mcy7880/R820T2-and-STM32F407-SDR-receiver/Doc/r820t_module pinout.pdf

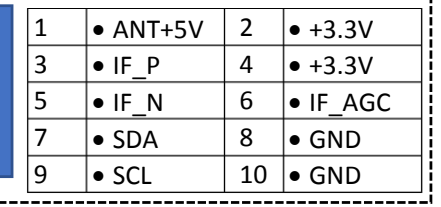
[picture p1: figure]
• ANT+5V; • IF_AGC; • SDA; • GND; • SCL

RF_IN

RF_LOOP

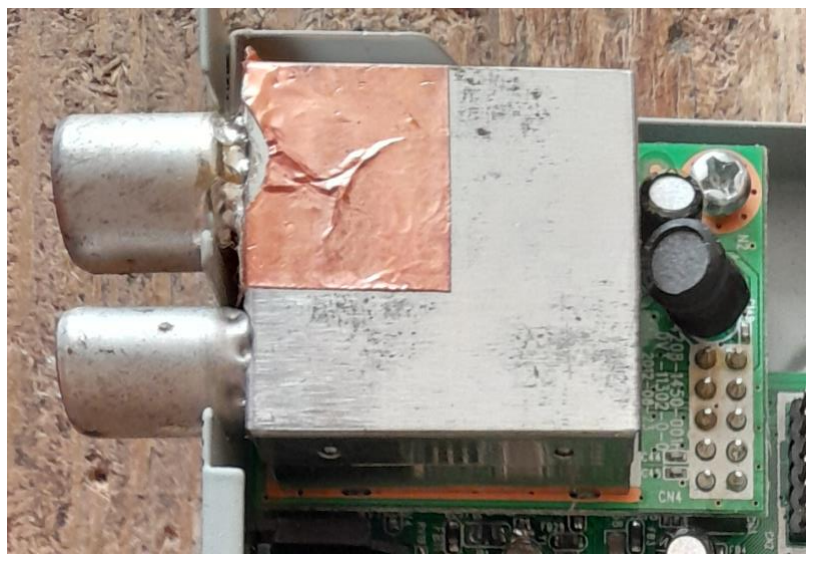
[picture p2: figure]
