mcy7880/R820T2-and-STM32F407-SDR-receiver/Doc/up_converter_schematic/up_converter.pdf

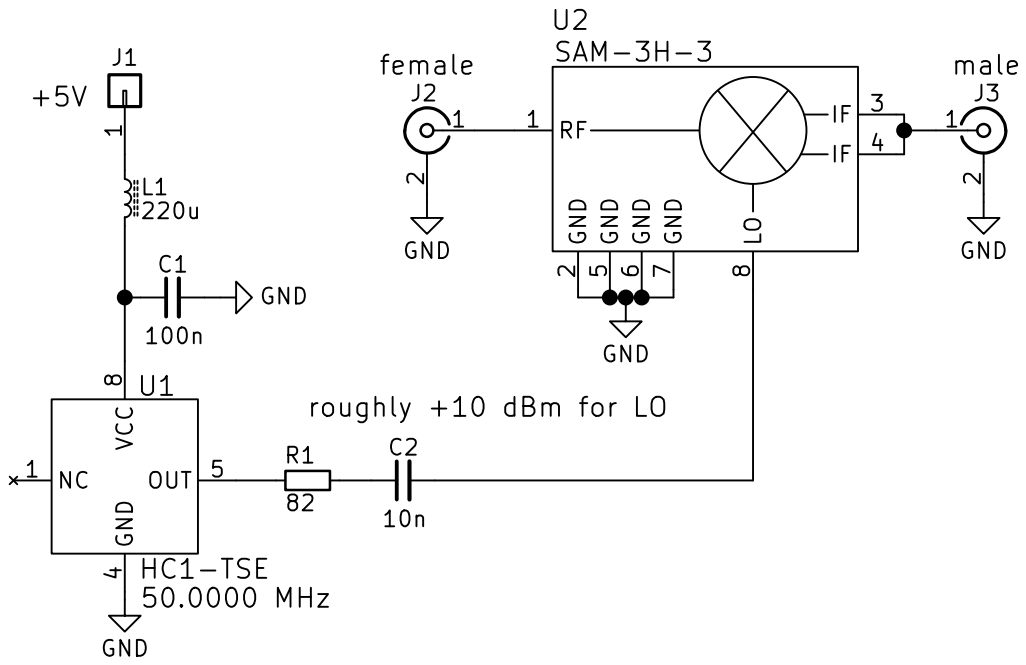
[picture p4: page 1]
