mcy7880/R820T2-and-STM32F407-SDR-receiver/Doc/if_amp_schematic/schematic.pdf

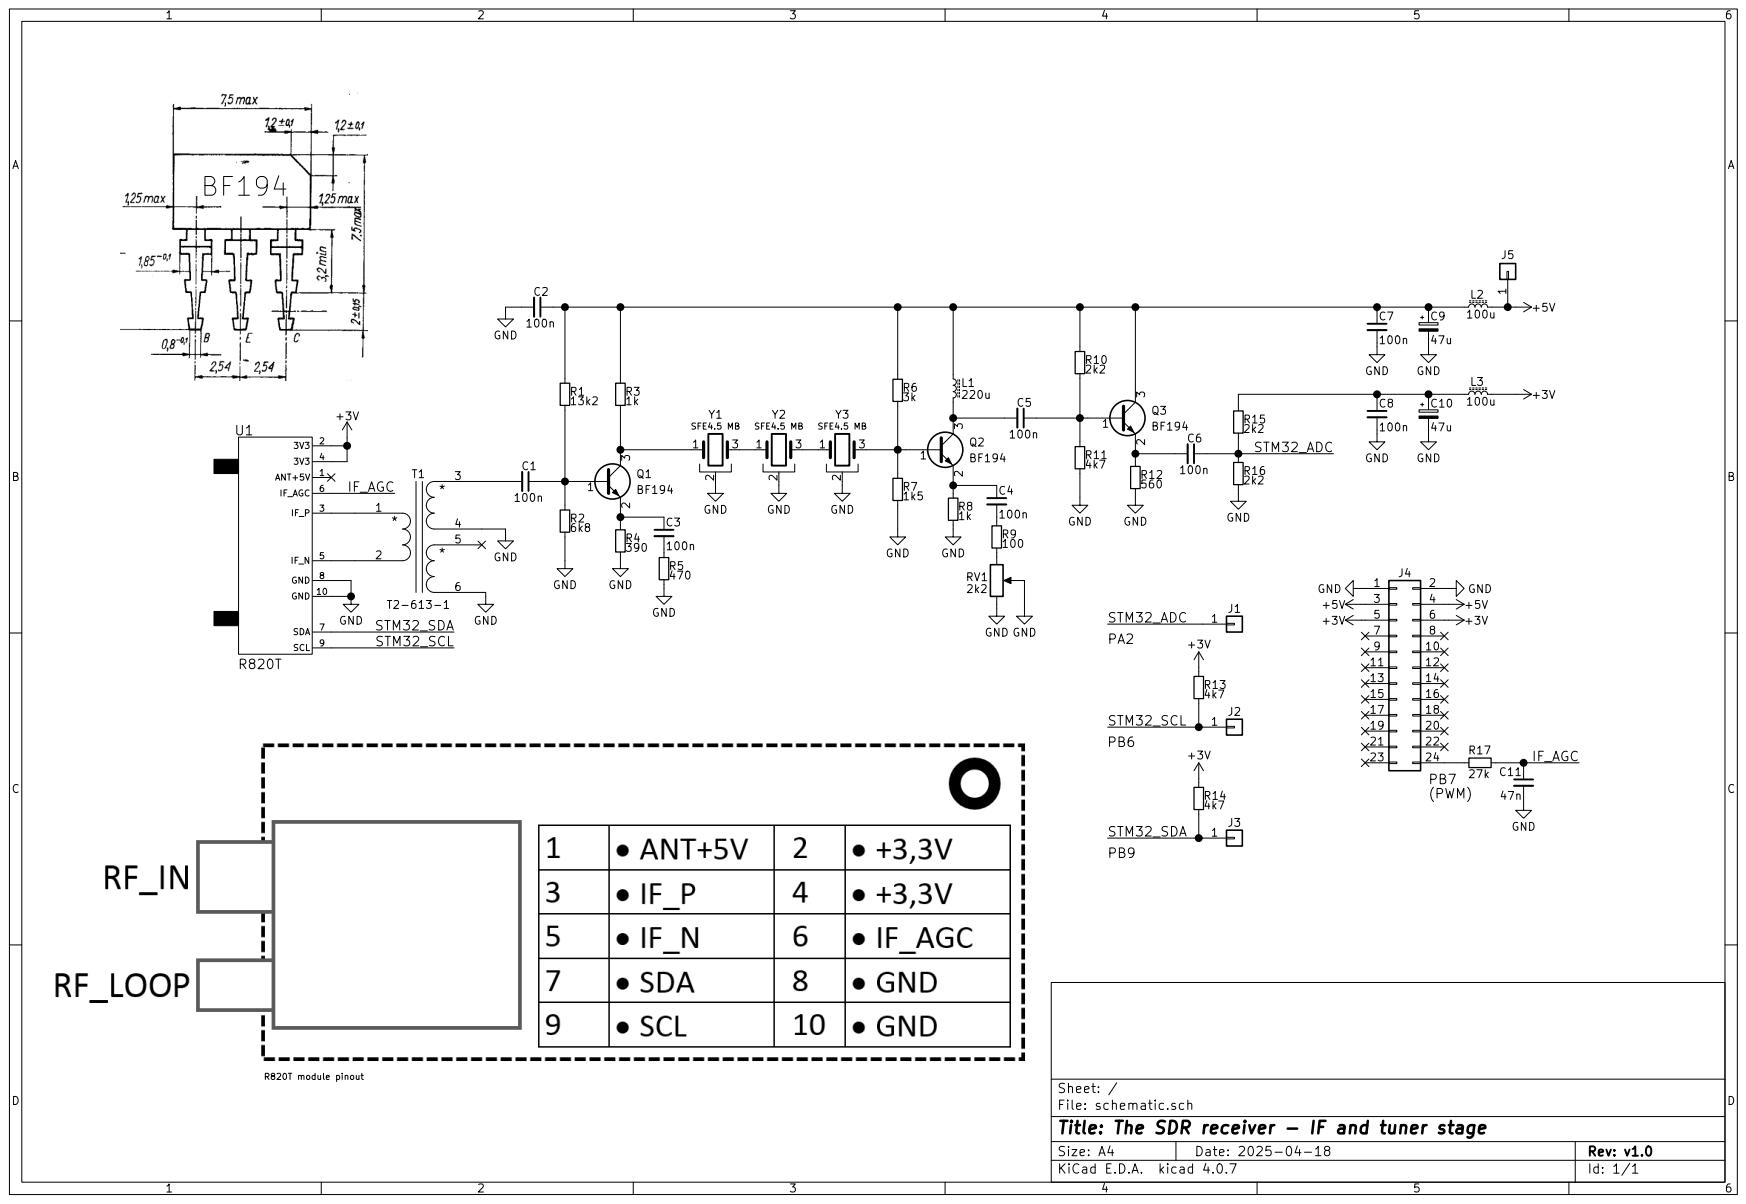
[picture p5: page 1]
