mcy7880/R820T2-and-STM32F407-SDR-receiver/stm32f407_r820t2/Core/Inc/cmd.h

/*
 * cmd.h - Command parsing routines for STM32F030 breakout
 * 02-15-17 E. Brombaugh
 */
 
#ifndef __cmd__
#define __cmd__

#include "main.h"

extern void init_cmd(void);
extern void cmd_parse(char ch);
void set_IQ_filters_coeff(float* b, float* a, Output_demod_type_enum Demod_Type);

#endif
