mcy7880/R820T2-and-STM32F407-SDR-receiver/(notices)

Notices in the files:
stm32f407_r820t2/Core/Inc/main.h:
Copyright (c) 2025 STMicroelectronics.
All rights reserved.
This software is licensed under terms that can be found in the LICENSE file
